mrzign/nRFdrip/Resources/Design/P1B/Schematic_nRFdrip_v1_P1B.pdf

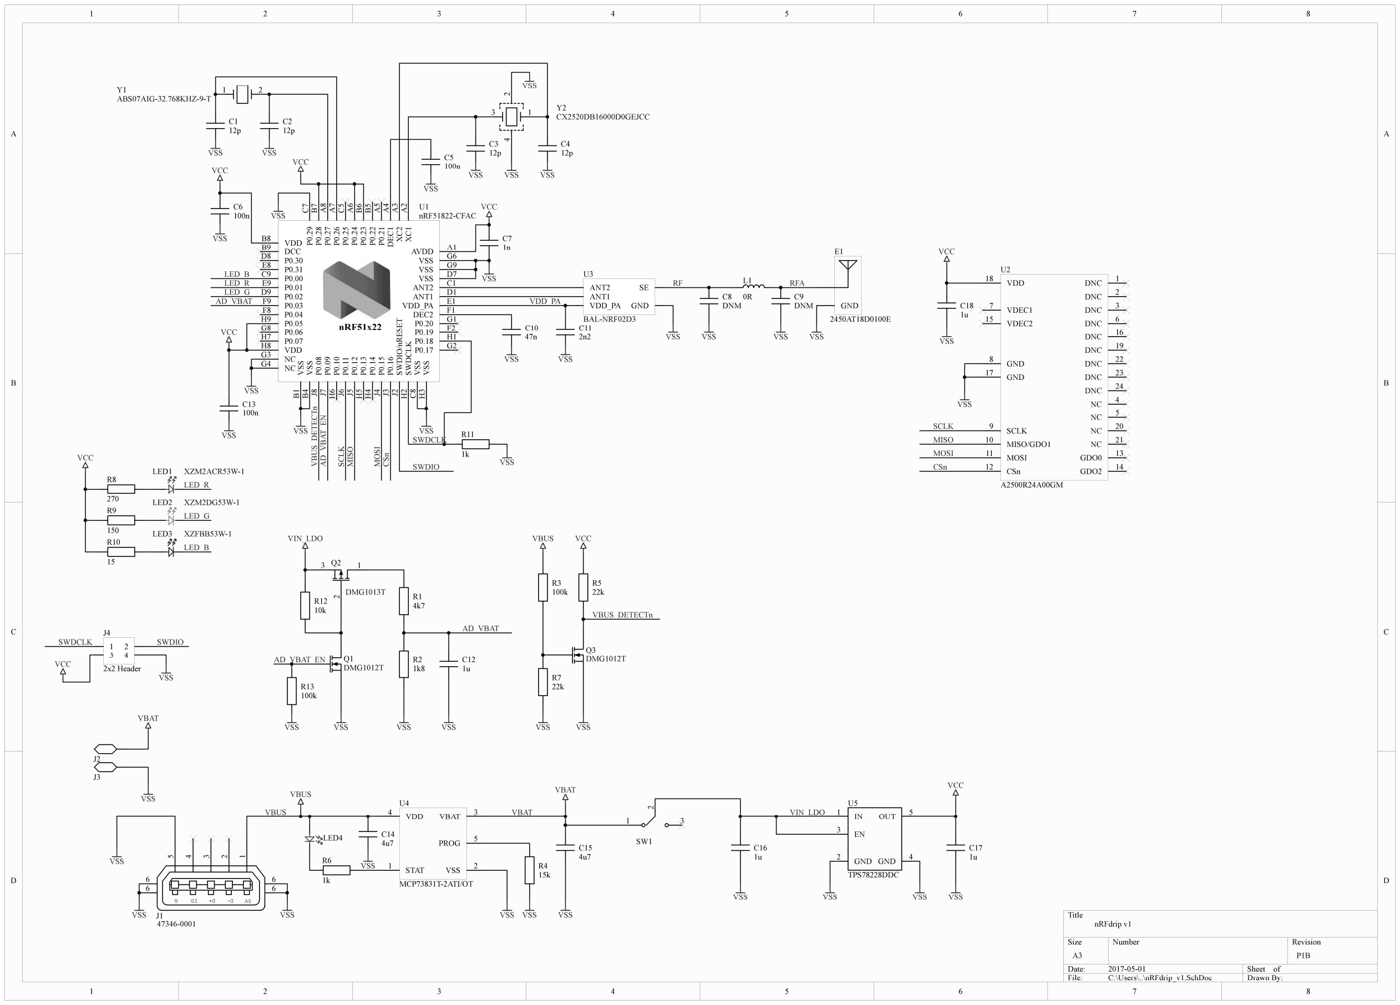
[picture p2: page 1]

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
Title

Size | Number | Revision
A3
Date: | 2017-05-01 | Sheet of
File: | C:\Users\..\nRFdrip_v1.SchDoc | Drawn By:

100n

C13

VSS

SWDIO

SWDCLK

100n

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
ABS07AIG-32.768KHZ-9-T

Y1

12p

C1
12p

C2

VSS | VSS | 12p C3
12p

C4

VSS | VSS
3 | 1 4 2 | CX2520DB16000D0GEJCC
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
RF SE
ANT1
VDD_PA GND

ANT2

BAL-NRF02D3

U3 VSS

VSS | VSS

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
100n

C5

VSS

RFA

VSS

DNM

C8 VDD_PA

VSS

A2500R24A00GM

DNC | 1
DNC | 2
DNC | 3
NC | 4

VDD 18

DNC | 6
DNC | 16
DNC | 19

VDEC1 7

GND 8

SCLK 9
MISO/GDO1 10
MOSI 11
CSn 12
GDO0 | 13
GDO2 | 14

VDEC2 15

| DNC | 22
GND 17 | DNC | 23
| DNC | 24
| NC | 5
| NC | 20
| NC | 21

U2

47346-0001 | 5V D- D+ ID G

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
MCP73831T-2ATI/OT

VDD 4

STAT 1

VBAT | 3
PROG | 5
VSS | 2

U4
VBUS

VSS

15k

R4

VSS | VSS | VSS VSS

VSS

VBAT

VBAT

LED1 | XZM2ACR53W-1
LED2 | XZM2DG53W-1

LED4

1k

R6

SCLK
MISO
MOSI
CSn

VSS

VCC

TPS78228DDC

IN 1

GND 2

EN 3

GND | 4
OUT | 5

U5

VSS | VSS

VCC

1u

C17

VSS | VSS

1u

C16

LED3 XZFBB53W-1

1 2
3

SW1

VIN_LDO

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
LED_R

LED_G

LED_B

J2

J3

VSS

VBAT

2x2 Header

1 2
3 4

J4

VSS

SWDCLK | SWDIO

VCC

1k

R11

VSS

2450AT18D0100E

GND

E1

DMG1012T

Q1

VIN_LDO

VSS

10k

R12

VSS

AD_VBAT

AD_VBAT_EN

100k

R13

VSS | SCLK MISO | MOSI CSn

LED_B
LED_R
LED_G
AD_VBAT | AD_VBAT_EN

VCC

VSS | nRF51822-CFAC

### nRF51x22

VDD B8

VDD H8 | VSS B¹
VDD_PA | E1 ANT1 | D1 ANT2 | C1 VSS B⁴ | VSS C⁸
AVDD | A1 XC¹ A² XC² A³

DCC B9
P0.30 D8

P0.00 C9
P0.01 E9
P0.02 D9
P0.03 F9
P0.04 F8
P0.05 H9
P0.06 G8
P0.07 H7 | P⁰.08 J8 P⁰.09 J7 P⁰.10 H⁶ P⁰.11 J6 | DEC¹ A⁴ P⁰.21 A⁵ P⁰.22 B⁵ P⁰.23 B⁶ P⁰.24 A⁶ P⁰.25 C⁵ P⁰.27 A⁸ P⁰.26 A⁷ P⁰.29 C⁷ P⁰.28 B⁷
P0.17 | G2 P0.18 | H1 P0.19 | F2 P0.20 | G1 DEC2 | F1 P⁰.12 J5 P⁰.13 H⁵ P⁰.14 H⁴ P⁰.15 J4 | SWDIO/nRESET J2 SWDCLK H² P⁰.16 J3

P0.31 E8
VSS | D7
VSS | G6
VSS | G9 VSS H³

NC G3
NC G4

U1

DMG1013T

1 2

### 3 Q2

DMG1012T

Q3

22k

R7

100k

R3

VSS VSS

VBUS

VBUS

22k

R5

VCC

VBUS_DETECTn VBUS_DETECTn

4u7

C15 4u7

C14

VSS

nRFdrip v1

P1B
