mrzign/nRFdrip/docs/images/nRFgo_1.png

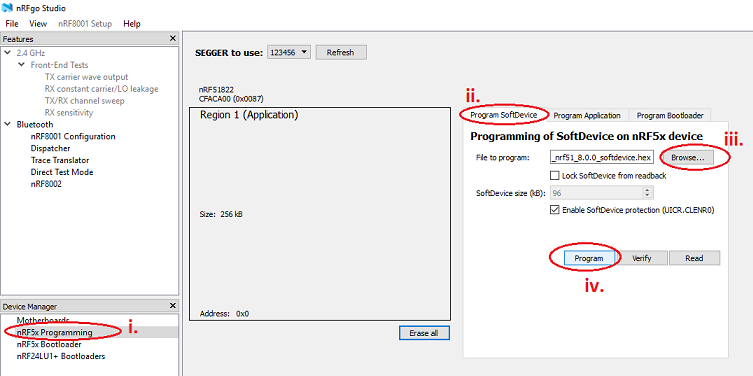
docs/images/nRFgo_1.png
