mrzign/nRFdrip/docs/images/nRFgo_2.png

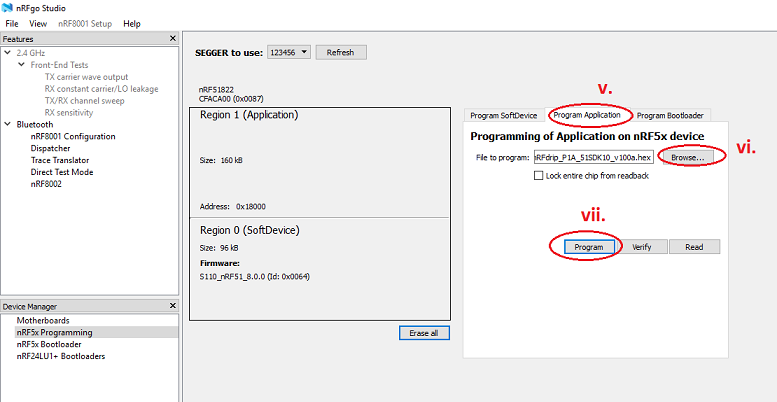
docs/images/nRFgo_2.png
