mrzign/nRFdrip/docs/images/xBridge_battery_level.png

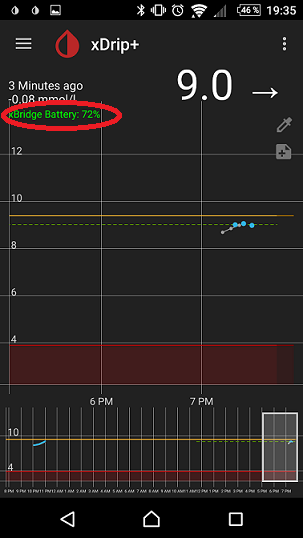
docs/images/xBridge_battery_level.png
