mrzign/nRFdrip/Resources/Design/P1B/BillOfMaterial_nRFdrip_v1_P1B.xlsx

Designator | Manufacturer | Part Name | Package | Value | Supplyer PN | Link | Alt. Supplyer PN | Link
U1 | Nordic Semiconductor | NRF51822-CFAC-R | BGA-62 |  | 1490-1041-6-ND | https://www.digikey.com/product-detail/en/Nordic-Semiconductor-ASA/NRF51822-CFAC-R/1490-1041-6-ND/5044285 | 949-NRF51822-CFAC-R | http://www2.mouser.com/ProductDetail/Nordic-Semiconductor/nRF51822-CFAC-R/?qs=ts7L7qAQc8c9Jix28wVJWg==
U2 | Anaren | A2500R24A00GM |  |  | 1173-1031-ND | https://www.digikey.com/product-detail/en/anaren/A2500R24A00GM/1173-1031-ND/3069153 | 620-A2500R24A00GM | http://www2.mouser.com/ProductDetail/Anaren/A2500R24A00GM/
U3 | ST | BAL-NRF02D3 | BAL-UFBGA-5pin |  | 497-14009-1-ND | https://www.digikey.com/product-detail/en/stmicroelectronics/BAL-NRF02D3/497-14009-1-ND/4441116 | 511-BAL-NRF02D3 | http://www2.mouser.com/ProductDetail/STMicroelectronics/BAL-NRF02D3/
U4 | Microchip | MCP73831T-2ATI/OT | SOT23-5 |  | MCP73831T-2ATI/OTCT-ND | https://www.digikey.com/product-detail/en/microchip-technology/MCP73831T-2ATI-OT/MCP73831T-2ATI-OTCT-ND/1979803 | 579-MCP73831T-2ATIOT | http://www2.mouser.com/ProductDetail/Microchip/MCP73831T-2ATI-OT/
U5 | TI | TPS78228DDC | TSOT-23-5 |  | 296-23826-1-ND | https://www.digikey.com/product-detail/en/texas-instruments/TPS78228DDCR/296-23826-1-ND/1958764 | 595-TPS78228DDCR | http://www2.mouser.com/ProductDetail/Texas-Instruments/TPS78228DDCR/?qs=io7aH2hdVh6nqQAH0TJKVQ==
Y1 | Abracon | ABS07AIG-32.768KHZ-9-T | 3215 |  | 535-13349-1-ND | https://www.digikey.com/product-detail/en/abracon-llc/ABS07AIG-32.768KHZ-9-T/535-13349-1-ND/5817603 | 815-S07AIG-32.768-9T | http://www2.mouser.com/ProductDetail/ABRACON/ABS07AIG-32768kHz-9-T/
Y2 | AVX | CX2520DB16000D0GEJCC | 2520 |  | 1253-1122-1-ND | https://www.digikey.com/product-detail/en/avx-corp-kyocera-corp/CX2520DB16000D0GEJCC/1253-1122-1-ND/4453945 | 581-CX2520DB16DGEJCC | http://www2.mouser.com/ProductDetail/AVX-Kyocera/CX2520DB16000D0GEJCC/
J1 | Molex | 47346-0001 |  |  | WM17141CT-ND | https://www.digikey.com/product-detail/en/molex-llc/0473460001/WM17141CT-ND/1782474 | 538-47346-0001 | http://www2.mouser.com/ProductDetail/Molex/47346-0001/
J4 | Harwin | M20-7810245 |  |  | 952-3207-ND | https://www.digikey.com/product-detail/en/harwin-inc/M20-7810245/952-3207-ND/6564943 | 855-M20-7810245 | http://www2.mouser.com/ProductDetail/Harwin/M20-7810245/
SW1 | E-Switch | EG1247 |  |  | EG1247-ND | https://www.digikey.com/product-detail/en/e-switch/EG1247/EG1247-ND/1804449 | 612-EG1247 | http://www2.mouser.com/ProductDetail/E-Switch/EG1247/
LED1_R, LED4 | SunLED | XZM2ACR53W-1 | LED_0603 |  | 1497-1146-1-ND | https://www.digikey.com/product-detail/en/sunled/XZM2ACR53W-1/1497-1146-1-ND/4745620
LED2_G | SunLED | XZM2DG53W-1 | LED_0603 |  | 1497-1161-1-ND | https://www.digikey.com/product-detail/en/sunled/XZM2DG53W-1/1497-1161-1-ND/4745633
LED3_B | SunLED | XZFBB53W-1 | LED_0603 |  | 1497-1310-1-ND | https://www.digikey.com/product-detail/en/sunled/XZFBB53W-1/1497-1310-1-ND/6615742
C1,C2,C3,C4 |  |  | CAP_0402 | 12p | 490-5924-1-ND | https://www.digikey.com/product-detail/en/murata-electronics-north-america/GRM1555C1H120JA01D/490-5924-1-ND/3721281
C5,C6,C13 |  |  | CAP_0402 | 100n | 490-3261-1-ND | https://www.digikey.com/product-detail/en/murata-electronics-north-america/GRM155R71C104KA88D/490-3261-1-ND/702802
C7 |  |  | CAP_0402 | 1n | 490-1303-1-ND | https://www.digikey.com/product-detail/en/murata-electronics-north-america/GRM155R71H102KA01D/490-1303-1-ND/587936
C10 |  |  | CAP_0402 | 47n | 490-3254-1-ND | https://www.digikey.com/product-detail/en/murata-electronics-north-america/GRM155R71E473KA88D/490-3254-1-ND/702795
C11 |  |  | CAP_0402 | 2n2 | 490-1305-1-ND | https://www.digikey.com/product-detail/en/murata-electronics-north-america/GRM155R71H222KA01D/490-1305-1-ND/587945
C12 |  |  | CAP_0402 | 1u | 490-1320-1-ND | https://www.digikey.com/product-detail/en/murata-electronics-north-america/GRM155R60J105KE19D/490-1320-1-ND/587919
C14,C15 |  |  | CAP_0603 | 4u7 | 490-7205-1-ND | https://www.digikey.com/product-detail/en/murata-electronics-north-america/GRM188R6YA475KE15D/490-7205-1-ND/3900448
C16,C17,C18 |  |  | CAP_0603 | 1u | 490-3897-1-ND | https://www.digikey.com/product-detail/en/murata-electronics-north-america/GRM188R61E105KA12D/490-3897-1-ND/965939
L1 |  |  | IND_0402 | 0R | 311-0.0JRCT-ND | https://www.digikey.com/product-detail/en/yageo/RC0402JR-070RL/311-0.0JRCT-ND/729353
R1 |  |  | RES_0402 | 4k7 | 311-4.7KLRCT-ND | https://www.digikey.com/product-detail/en/yageo/RC0402FR-074K7L/311-4.7KLRCT-ND/2827881
R2 |  |  | RES_0402 | 1k8 | 311-1.80KLRCT-ND | https://www.digikey.com/product-detail/en/yageo/RC0402FR-071K8L/311-1.80KLRCT-ND/729467
R3,R13 |  |  | RES_0402 | 100k | 311-100KLRCT-ND | https://www.digikey.com/product-detail/en/yageo/RC0402FR-07100KL/311-100KLRCT-ND/729473
R4 |  |  | RES_0402 | 15k | 311-15.0KLRCT-ND | https://www.digikey.com/product-detail/en/yageo/RC0402FR-0715KL/311-15.0KLRCT-ND/729488
R5,R7 |  |  | RES_0402 | 22k | 311-22.0KLRCT-ND | https://www.digikey.com/product-detail/en/yageo/RC0402FR-0722KL/311-22.0KLRCT-ND/729508
R6,R11 |  |  | RES_0402 | 1k | 311-1.00KLRCT-ND | https://www.digikey.com/product-detail/en/yageo/RC0402FR-071KL/311-1.00KLRCT-ND/729460
R8 |  |  | RES_0402 | 270 | 311-270LRCT-ND | https://www.digikey.com/product-detail/en/yageo/RC0402FR-07270RL/311-270LRCT-ND/2827902
R9 |  |  | RES_0402 | 150 | 311-150LRCT-ND | https://www.digikey.com/product-detail/en/yageo/RC0402FR-07150RL/311-150LRCT-ND/729490
R10 |  |  | RES_0402 | 15 | 311-15LRCT-ND | https://www.digikey.com/product-detail/en/yageo/RC0402FR-0715RL/311-15LRCT-ND/2827914
R12 |  |  | RES_0402 | 10k | 311-10.0KLRCT-ND | https://www.digikey.com/product-detail/en/yageo/RC0402FR-0710KL/311-10.0KLRCT-ND/729470
Box | Takashi | PS-65W |  |  | 2444560 | http://uk.farnell.com/takachi/ps-65w/pcb-enclosure-abs-white/dp/2444560
Battery | Li-Ion | SD 301423 (3.0x14x23 mm 110mAh) |  |  | 32776161138 | https://www.aliexpress.com/item/3-7V-polymer-lithium-battery-301423-110MAH-Meizu-MP3-Bluetooth-headset-small-speaker-toy/32776161138.html
Debugger |  |  |  |  | 32622682260 | https://www.aliexpress.com/item/CJMCU-Jlink-for-SWD-Jlink-3-Wire-for-STM32-on-SWD-Debug/32622682260.html
