mrzign/nRFdrip/Resources/Datasheets/ps-65.dxf

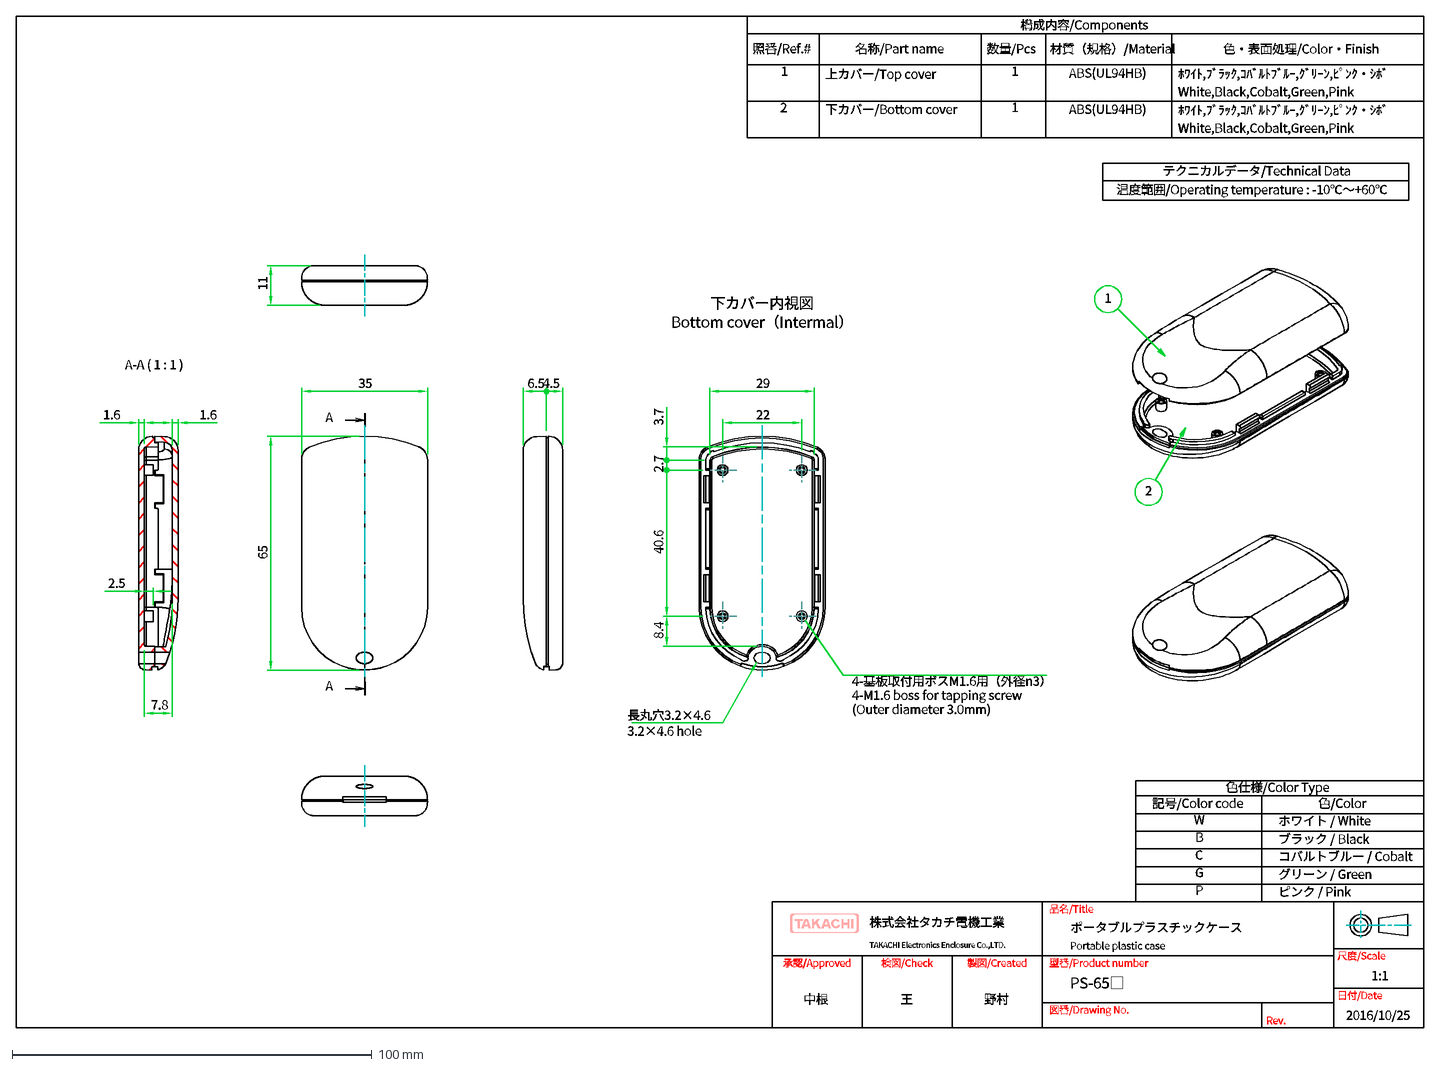
[picture p8: CAD file, 2017-05-02]
Resources/Datasheets/ps-65.dxf
ポータブルプラスチックケース
PS-65□
1:1
2016/10/25
王
野村
中根
Portable plastic case
品名/Title
型番/Product number
図番/Drawing No.
承認/Approved
検図/Check
製図/Created
Rev.
株式会社タカチ電機工業
尺度/Scale
日付/Date
TAKACHI Electronics Enclosure Co.,LTD.
A
A-A ( 1 : 1 )
下カバー内視図 Bottom cover（Intermal）
35
6.5
4.5
29
22
1.6
2.5
7.8
3.7
40.6
2.7
8.4
65
11
長丸穴3.2×4.6 3.2×4.6 hole
構成内容/Components
色・表面処理/Color・Finish
材質（規格）/Material
数量/Pcs
名称/Part name
照番/Ref.#
ﾎﾜｲﾄ,ﾌﾞﾗｯｸ,ｺﾊﾞﾙﾄﾌﾞﾙｰ,ｸﾞﾘｰﾝ,ﾋﾟﾝｸ・ｼﾎﾞ
White,Black,Cobalt,Green,Pink
ABS(UL94HB)
1
上カバー/Top cover
下カバー/Bottom cover
2
テクニカルデータ/Technical Data
温度範囲/Operating temperature : -10℃～+60℃
色仕様/Color Type
記号/Color code
色/Color
W
ホワイト / White
B
ブラック / Black
C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
