mrzign/nRFdrip/docs/images/nRFdrip_manual_overview.png

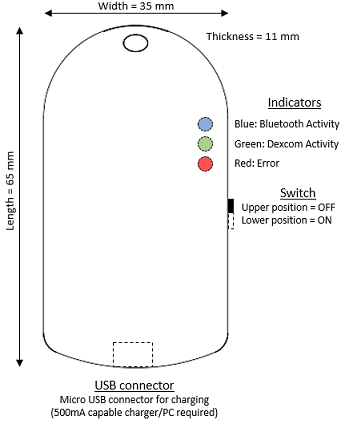
docs/images/nRFdrip_manual_overview.png
