mrzign/nRFdrip/docs/images/nRFdrip_debug.png

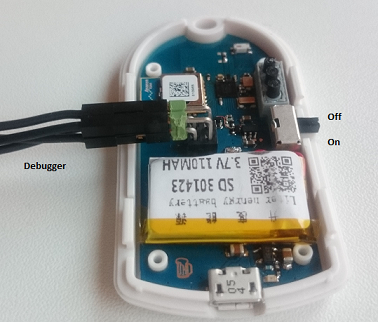
docs/images/nRFdrip_debug.png
