mrzign/nRFdrip/docs/images/nRFdrip_debug_2.png

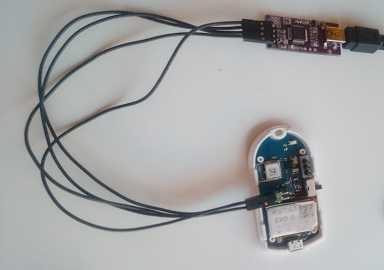
docs/images/nRFdrip_debug_2.png
