mrzign/nRFdrip/Resources/Design/P1B/Placement_nRFdrip_v1_P1B.pdf

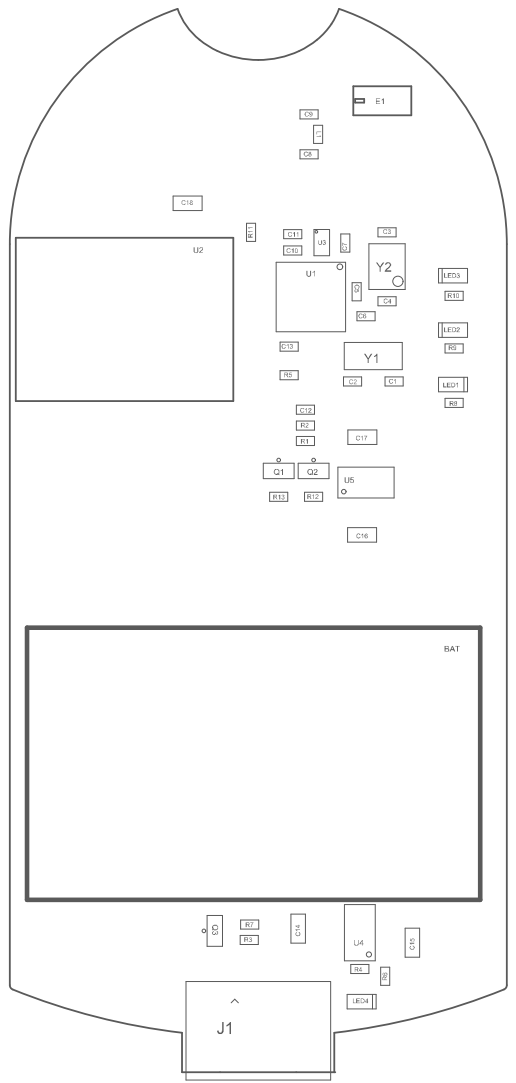
[picture p12: page 1]
